Manawyrm/ISA8019/PCB/gerbers/RevA/ISA8019.pdf

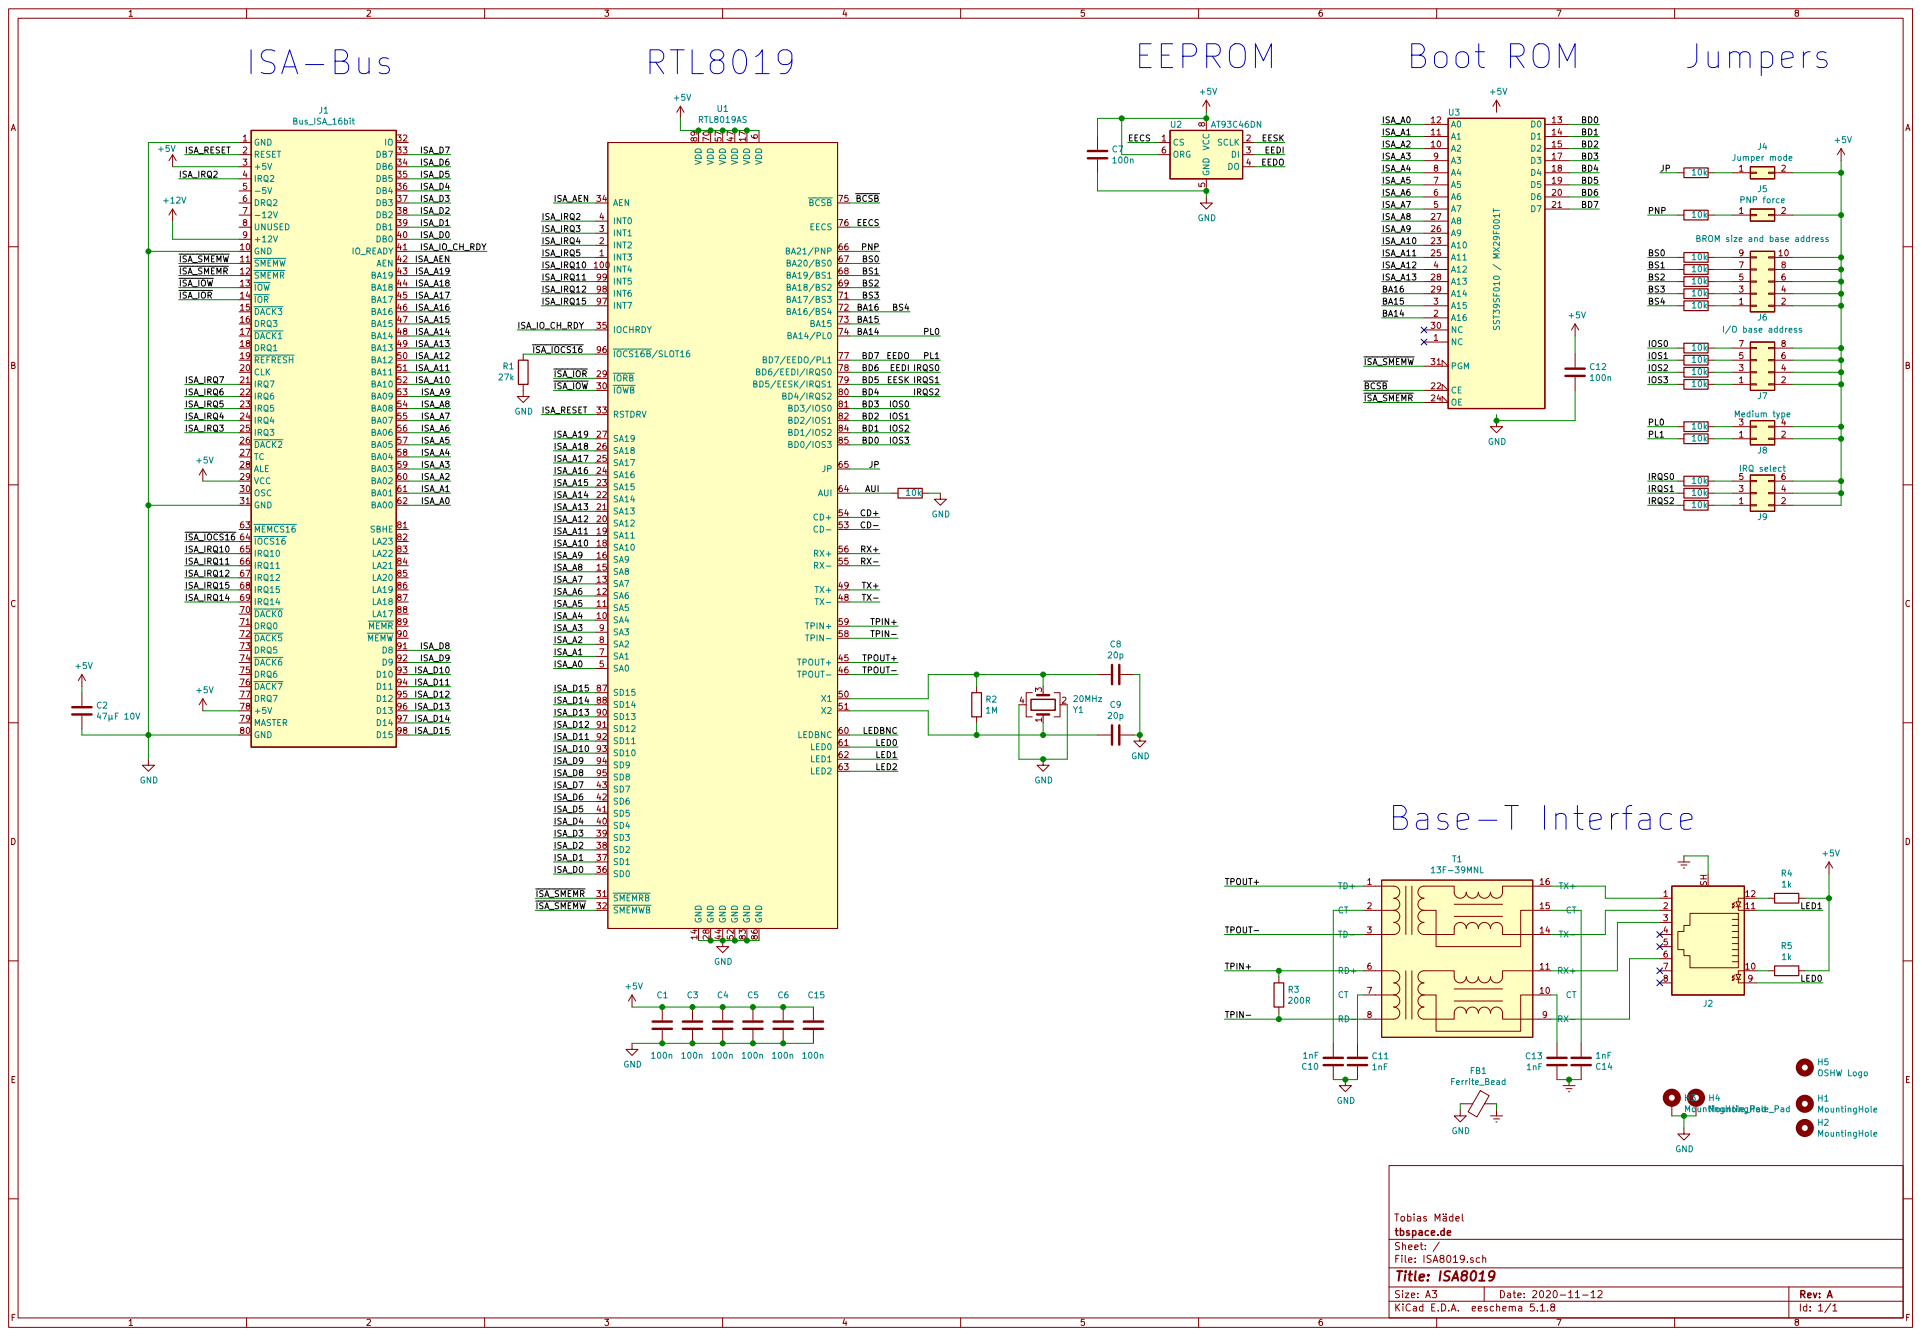
[picture p1: page 1]

J6 BROM size and base address C9

File: ISA8019.sch Sheet: / tbspace.de Tobias Mädel
