Manawyrm/ISA8019/PCB/ISA8019.kicad_pcb

## KiCad design PCB/ISA8019.kicad_pcb (2020-11-15)

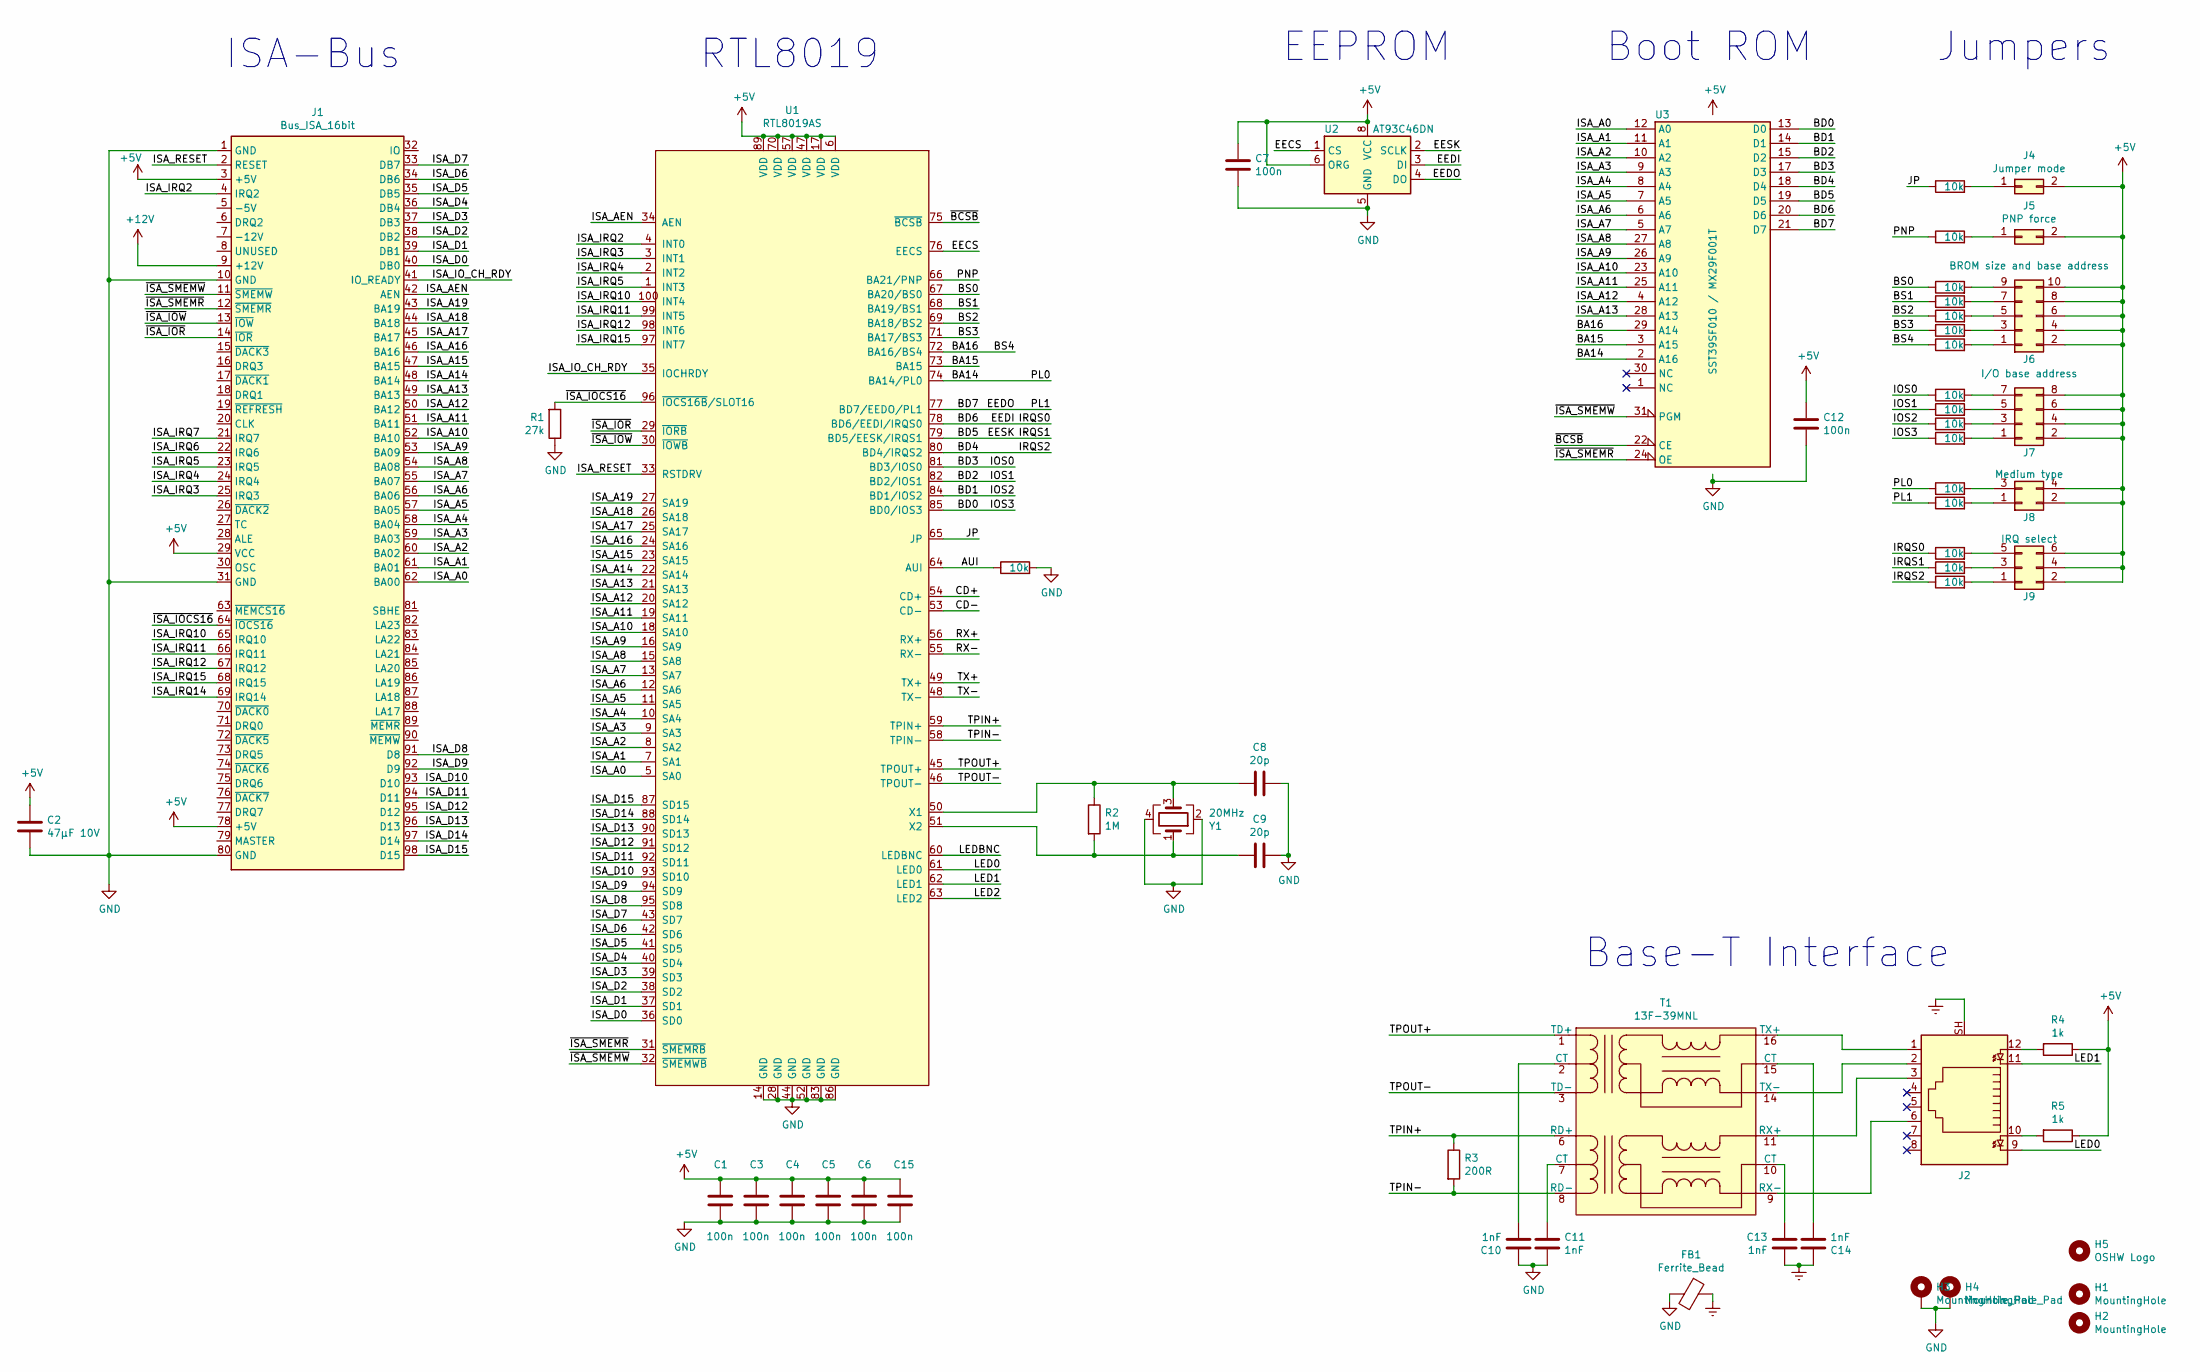
[picture p2: schematic ISA8019.sch]

Parts:
C1, C3, C4, C5, C6, C7, C12, C15: 100n; C_0402_1005Metric; LCSC C1525
C2: 47µF 10V; C_1206_3216Metric; LCSC C96123
C8, C9: 20p; C_0402_1005Metric; LCSC C1554
C10, C11, C13, C14: 1nF; C_1206_3216Metric; LCSC C9196
FB1: Ferrite_Bead; L_0805_2012Metric; LCSC C1017
H1, H2: MountingHole; ToolingHole_JLCSMT
H3, H4: MountingHole_Pad; MountingHole_3.2mm_M3_Pad_Via
H5: OSHW Logo; OSHW-Logo_11.4x12mm_Copper
J1: Bus_ISA_16bit; BUS_AT_WO_SILKSCREEN
J2: 8P8C_Shielded; 8P8C_yellow_green_Ckmtw_C133529
J4: Jumper mode; PinHeader_2x01_P2.54mm_Vertical
J5: PNP force; PinHeader_2x01_P2.54mm_Vertical
J6: BROM size and base address; PinHeader_2x05_P2.54mm_Vertical
J7: I/O base address; PinHeader_2x04_P2.54mm_Vertical
J8: Medium type; PinHeader_2x02_P2.54mm_Vertical
J9: IRQ select; PinHeader_2x03_P2.54mm_Vertical
R1: 27k; R_0402_1005Metric; LCSC C25771
R2: 1M; R_0402_1005Metric; LCSC C26083
R3: 200R; R_0402_1005Metric; LCSC C25087
R4, R5: 1k; R_0402_1005Metric; LCSC C11702
R6, R7, R8, R9, R10, R11, R12, R13, R14, R15, R16, R17, R18, R19, R20, R21, R22: 10k; R_0402_1005Metric; LCSC C25744
T1: 13F-39MNL; SOIC-16W-12_7.5x10.3mm_P1.27mm; LCSC C115949
U1: RTL8019AS; LQFP-14x20mm_P0.5mm; LCSC C10016
U2: AT93C46DN; SOIC-8_3.9x4.9mm_P1.27mm; LCSC C6499
U3: SST39SF010 / MX29F001T; DIP-32_W15.24mm_Socket_LongPads
Y1: 20MHz; Crystal_SMD_3225-4Pin_3.2x2.5mm; LCSC C110936

Connections:
+5V: C1.1, C2.1, C3.1, C4.1, C5.1, C6.1, C7.1, C12.1, C15.1, J1.3 (+5V), J1.29 (VCC), J1.78 (+5V), J4.2, J5.2, J6.2, J6.4, J6.6, J6.8, J6.10, J7.2, J7.4, J7.6, J7.8, J8.2, J8.4, J9.2, J9.4, J9.6, R4.1, R5.1, U1.6 (VDD), U1.17 (VDD), U1.47 (VDD), U1.57 (VDD), U1.70 (VDD), U1.89 (VDD), U2.6 (ORG), U2.8 (VCC), U3.32 (VCC)
+12V: J1.9 (+12V)
/AUI: R6.1, U1.64 (AUI)
/BA14: R18.1, U1.74 (BA14/PL0), U3.2 (A16)
/BA15: U1.73 (BA15), U3.3 (A15)
/BA16: R13.1, U1.72 (BA16/BS4), U3.29 (A14)
/BD0: R17.1, U1.85 (BD0/IOS3), U3.13 (D0)
/BD1: R16.1, U1.84 (BD1/IOS2), U3.14 (D1)
/BD2: R15.1, U1.82 (BD2/IOS1), U3.15 (D2)
/BD3: R14.1, U1.81 (BD3/IOS0), U3.17 (D3)
/BD4: R22.1, U1.80 (BD4/IRQS2), U3.18 (D4)
/BD5: R21.1, U1.79 (BD5/EESK/IRQS1), U2.2 (SCLK), U3.19 (D5)
/BD6: R20.1, U1.78 (BD6/EEDI/IRQS0), U2.3 (DI), U3.20 (D6)
/BD7: R19.1, U1.77 (BD7/EEDO/PL1), U2.4 (DO), U3.21 (D7)
/BS0: R9.1, U1.67 (BA20/BS0)
/BS1: R10.1, U1.68 (BA19/BS1)
/BS2: R11.1, U1.69 (BA18/BS2)
/BS3: R12.1, U1.71 (BA17/BS3)
/CD+: U1.54 (CD+)
/CD-: U1.53 (CD-)
/EECS: U1.76 (EECS), U2.1 (CS)
/ISA_A0: J1.62 (BA00), U1.5 (SA0), U3.12 (A0)
/ISA_A1: J1.61 (BA01), U1.7 (SA1), U3.11 (A1)
/ISA_A2: J1.60 (BA02), U1.8 (SA2), U3.10 (A2)
/ISA_A3: J1.59 (BA03), U1.9 (SA3), U3.9 (A3)
/ISA_A4: J1.58 (BA04), U1.10 (SA4), U3.8 (A4)
/ISA_A5: J1.57 (BA05), U1.11 (SA5), U3.7 (A5)
/ISA_A6: J1.56 (BA06), U1.12 (SA6), U3.6 (A6)
/ISA_A7: J1.55 (BA07), U1.13 (SA7), U3.5 (A7)
/ISA_A8: J1.54 (BA08), U1.15 (SA8), U3.27 (A8)
/ISA_A9: J1.53 (BA09), U1.16 (SA9), U3.26 (A9)
/ISA_A10: J1.52 (BA10), U1.18 (SA10), U3.23 (A10)
/ISA_A11: J1.51 (BA11), U1.19 (SA11), U3.25 (A11)
/ISA_A12: J1.50 (BA12), U1.20 (SA12), U3.4 (A12)
/ISA_A13: J1.49 (BA13), U1.21 (SA13), U3.28 (A13)
/ISA_A14: J1.48 (BA14), U1.22 (SA14)
/ISA_A15: J1.47 (BA15), U1.23 (SA15)
/ISA_A16: J1.46 (BA16), U1.24 (SA16)
/ISA_A17: J1.45 (BA17), U1.25 (SA17)
/ISA_A18: J1.44 (BA18), U1.26 (SA18)
/ISA_A19: J1.43 (BA19), U1.27 (SA19)
/ISA_AEN: J1.42 (AEN), U1.34 (AEN)
/ISA_D0: J1.40 (DB0), U1.36 (SD0)
/ISA_D1: J1.39 (DB1), U1.37 (SD1)
/ISA_D2: J1.38 (DB2), U1.38 (SD2)
/ISA_D3: J1.37 (DB3), U1.39 (SD3)
/ISA_D4: J1.36 (DB4), U1.40 (SD4)
/ISA_D5: J1.35 (DB5), U1.41 (SD5)
/ISA_D6: J1.34 (DB6), U1.42 (SD6)
/ISA_D7: J1.33 (DB7), U1.43 (SD7)
/ISA_D8: J1.91 (D8), U1.95 (SD8)
/ISA_D9: J1.92 (D9), U1.94 (SD9)
/ISA_D10: J1.93 (D10), U1.93 (SD10)
/ISA_D11: J1.94 (D11), U1.92 (SD11)
/ISA_D12: J1.95 (D12), U1.91 (SD12)
/ISA_D13: J1.96 (D13), U1.90 (SD13)
/ISA_D14: J1.97 (D14), U1.88 (SD14)
/ISA_D15: J1.98 (D15), U1.87 (SD15)
/ISA_IO_CH_RDY: J1.41 (IO_READY), U1.35 (IOCHRDY)
/ISA_IRQ2: J1.4 (IRQ2), U1.4 (INT0)
/ISA_IRQ3: J1.25 (IRQ3), U1.3 (INT1)
/ISA_IRQ4: J1.24 (IRQ4), U1.2 (INT2)
/ISA_IRQ5: J1.23 (IRQ5), U1.1 (INT3)
/ISA_IRQ6: J1.22 (IRQ6)
/ISA_IRQ7: J1.21 (IRQ7)
/ISA_IRQ10: J1.65 (IRQ10), U1.100 (INT4)
/ISA_IRQ11: J1.66 (IRQ11), U1.99 (INT5)
/ISA_IRQ12: J1.67 (IRQ12), U1.98 (INT6)
/ISA_IRQ14: J1.69 (IRQ14)
/ISA_IRQ15: J1.68 (IRQ15), U1.97 (INT7)
/ISA_RESET: J1.2 (RESET), U1.33 (RSTDRV)
/JP: R7.1, U1.65 (JP)
/LED0: J2.9, U1.61 (LED0)
/LED1: J2.11, U1.62 (LED1)
/LED2: U1.63 (LED2)
/LEDBNC: U1.60 (LEDBNC)
/PNP: R8.1, U1.66 (BA21/PNP)
/RX+: U1.56 (RX+)
/RX-: U1.55 (RX-)
/TPIN+: R3.1, T1.6 (RD+), U1.59 (TPIN+)
/TPIN-: R3.2, T1.8 (RD-), U1.58 (TPIN-)
/TPOUT+: T1.1 (TD+), U1.45 (TPOUT+)
/TPOUT-: T1.3 (TD-), U1.46 (TPOUT-)
/TX+: U1.49 (TX+)
/TX-: U1.48 (TX-)
/~BCSB: U1.75 (~BCSB), U3.22 (CE)
/~ISA_IOCS16: J1.64 (~IOCS16), R1.2, U1.96 (~IOCS16B~/SLOT16)
/~ISA_IOR: J1.14 (~IOR), U1.29 (~IORB)
/~ISA_IOW: J1.13 (~IOW), U1.30 (~IOWB)
/~ISA_SMEMR: J1.12 (~SMEMR), U1.31 (~SMEMRB), U3.24 (OE)
/~ISA_SMEMW: J1.11 (~SMEMW), U1.32 (~SMEMWB), U3.31 (PGM)
Earth: C13.2, C14.1, FB1.1, J2.SH
GND: C1.2, C2.2, C3.2, C4.2, C5.2, C6.2, C7.2, C8.1, C9.1, C10.1, C11.2, C12.2, C15.2, FB1.2, H3.1, H4.1, J1.1 (GND), J1.10 (GND), J1.31 (GND), J1.80 (GND), R1.1, R6.2, U1.14 (GND), U1.28 (GND), U1.44 (GND), U1.52 (GND), U1.83 (GND), U1.86 (GND), U2.5 (GND), U3.16 (GND), Y1.2, Y1.4
unnamed: C8.2, R2.1, U1.50 (X1), Y1.3
unnamed: C9.2, R2.2, U1.51 (X2), Y1.1
unnamed: C10.2, T1.2 (CT)
unnamed: C11.1, T1.7 (CT)
unnamed: C13.1, T1.10 (CT)
unnamed: C14.2, T1.15 (CT)
unnamed: J2.1, T1.16 (TX+)
unnamed: J2.2, T1.14 (TX-)
unnamed: J2.3, T1.11 (RX+)
unnamed: J2.6, T1.9 (RX-)
unnamed: J2.10, R5.2
unnamed: J2.12, R4.2
unnamed: J4.1, R7.2
unnamed: J5.1, R8.2
unnamed: J6.1, R13.2
unnamed: J6.3, R12.2
unnamed: J6.5, R11.2
unnamed: J6.7, R10.2
unnamed: J6.9, R9.2
unnamed: J7.1, R17.2
unnamed: J7.3, R16.2
unnamed: J7.5, R15.2
unnamed: J7.7, R14.2
unnamed: J8.1, R19.2
unnamed: J8.3, R18.2
unnamed: J9.1, R22.2
unnamed: J9.3, R21.2
unnamed: J9.5, R20.2

Notes on the sheet:
Base-T Interface
ISA-Bus
RTL8019
Boot ROM
Jumpers
EEPROM

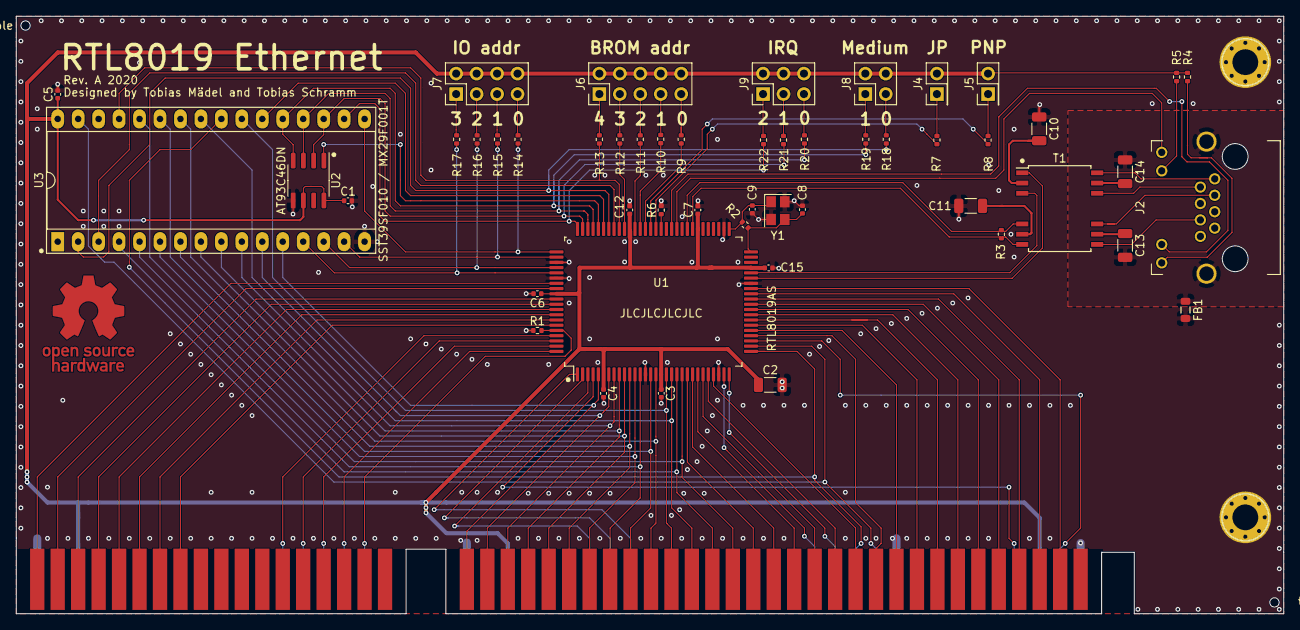
[picture p3: board ISA8019.kicad_pcb from above]

Board: 2 copper layers, 157.4 x 74.2 mm, 56 parts (0 on the bottom side), 109 nets.
