Manawyrm/ISA8019/Drivers/Crynwr packet driver - modified for 8bit operation/README.md

This driver was modified to work with 8bit ISA computers by profdc9.   
  
Source:  
http://www.vcfed.org/forum/showthread.php?41081-NE2000-Packet-drivers-for-8-bit-slots
