Manawyrm/ISA8019/(threads)

Thread 1 (2021-03-31):

Additional hardware

chregu82, 2021-03-31:
Hello
Could you please provide information about the RJ45 connector you used in your design?
Is there any suitable ISA bracket on the market?
Regards
Christian

Manawyrm, 2021-03-31:
Hello Christian,

The RJ45 connector is [Shenzhen Cankemeng C133529](https://lcsc.com/product-detail/Ethernet-Connectors-Modular-Connectors-RJ45-RJ11_Shenzhen-Cankemeng-56-LED_C133529.html)

Just recently, the part also started being [available at JLC for automated assembly](https://jlcpcb.com/parts/componentSearch?searchTxt=C133529).
This feature is brand-new, so I haven't tested it yet.
Every part has a "LCSC" property in KiCad, which contains a LCSC.com part number.
If you add that property with "C133529", automated assembly probably just works fine.

The optional header connectors for the jumpers can also be assembled now, if you add the LCSC part numbers. (again, untested).

The bracket is designed for a [Keystone Electronics 9202](https://www.mouser.de/ProductDetail/534-9202?R=9202virtualkey53400000virtualkey534-9202).

If you get your own boards made, I'd be happy to receive a photo :smiley:

Best regards
Tobias

chregu82, 2021-04-01:
Hello Tobias

Ok I tried adding every needed part for automated assembly at JLCPCB. It was a quite frustrating experience.
- They don't have the DIP socket
- The quarz is out of stock
- They don't have all needed pin headers available
So I would probably have to order the PCB with what they have and do the rest by myself. However it's also quite expensive to let them do the assembly. The RTL8019 alone costs about 8 times as much as if I would order it from Aliexpress.

Because of all that, I then had the idea, why not just order the PCB from JLCPCB and order the parts from Mouser / Aliexpress and do it all by myself. Then I realised that there are 0402 parts, which are really really small for hand soldering and also the quarz would be difficult.

With all this in mind I am now at a point where I think about redesigning what you did and changing it to THT parts where possible. This would probably be a better solution for the experienced hobbyist. Parts could be ordered at Aliexpress / Mouser, maybe even with several options for a specific part or different suppliers.

I'd really like to hear your opinion. The idea of building a NE2000 compatible card for old PCs is really great.

Best regards
Christian

Manawyrm, 2021-04-01:
Hi Christian,

there is a fork of this project where all the small resistors (optimized for JLC) were replaced with 0805 components which are easily handsolderable. (even easier then THT, imho!)

It was discussed in this thread:
https://dosreloaded.de/forum/index.php?thread/3877-neue-isa8019-netzwerkkarte-von-manawyrm/

The only special part is the RTL8019. You can buy everything else directly at LCSC, reichelt, etc.
No real need for mouser (except for the slot covers).

Best regards,
Tobias

Manawyrm, 2021-04-01:
PS: I just looked and saw the price for the RTL8019 at JLC. Oops! That‘s a new development, these things used to cost 0.93$ a couple of month ago!

aperezbios, 2021-11-10:
@Manawyrm FYI, the RJ45 connector part shows as discontinued on LCSC.com as of today: https://lcsc.com/product-detail/Ethernet-Connectors-Modular-Connectors-RJ45-RJ11_Shenzhen-Cankemeng-56-LED_C133529.html

[Further complicating things, LCSC appears to have re-assigned the C133529 part number to a new, completely different connector, made by the same company: ](https://lcsc.com/search?q=C133529)

So, the question then becomes...is there any other, currently-manufactured/available (possibly NOS) connector with a near-identical footprint? I have

aperezbios, 2021-11-10:
It appears this part may be identical, or at least have an identical footprint: https://lcsc.com/product-detail/Ethernet-Connectors-Modular-Connectors-span-style-background-color-ff0-RJ45-span-RJ11_BOOMELE-Boom-Precision-Elec-RJ45-B-1-1_C138392.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

aperezbios, 2021-11-10:
Digging in to this a bit more, it looks like the above Chinese-manufactured part is likely to be a clone/knock-off of the Wurth Elektronik 615008137421. The specification sheet for this part, which includes the mechanical dimensions, can be viewed at https://www.mouser.com/datasheet/2/445/615008137421-1718325.pdf

aperezbios, 2021-11-13:
I can confirm that the Wurth Elektronik 615008137421 part is a perfect match. The Chinese part is likely a clone of it. It mates perfectly in the PCB.
