Manawyrm/ISA8019/(commit log)

2020-11-10 Map pins, add pin type, symbol done
2020-11-12 Add schematic, copy parts of RC2014-Ethernet
2020-11-12 Add EEPROM and boot flash
    [ISA8019.sch]
2020-11-12 Add jumpers, AUI interface
    [ISA8019.kicad_pcb, ISA8019.sch]
2020-11-13 Add mechanicals
    [ISA8019.kicad_pcb, ISA8019.sch]
2020-11-14 Some routing
    [ISA8019-B_Cu.gbl, ISA8019-B_Mask.gbs, ISA8019-B_Paste.gbp, ISA8019-B_SilkS.gbo, ISA8019-Edge_Cuts.gm1, ISA8019-F_Cu.gtl, ISA8019-F_Mask.gts, ISA8019-F_Paste.gtp]
2020-11-14 some routing later
    [ISA8019.kicad_pcb]
2020-11-14 Redo most of the bus layout
    [ISA8019.kicad_pcb]
2020-11-14 Fix BA14/BA15 spacing below ROM
    [ISA8019.kicad_pcb]
2020-11-14 Route all nets
    [ISA8019.kicad_pcb]
2020-11-15 Add silkscreen and jumper settings
    [ISA8019.kicad_pcb, ISA8019.sch]
2020-11-15 Add JLC markings, manufacturing details and new gerbers
    [ISA8019-B_Cu.gbl, ISA8019-B_Mask.gbs, ISA8019-B_Paste.gbp, ISA8019-B_SilkS.gbo, ISA8019-Edge_Cuts.gm1, ISA8019-F_Cu.gtl, ISA8019-F_Mask.gts, ISA8019-F_Paste.gtp]
2020-11-15 More GND via stitching and minor aesthetic fixes
    [ISA8019.kicad_pcb]
2020-11-15 Small trace cleanup and new gerbers
    [ISA8019-B_Cu.gbl, ISA8019-B_Mask.gbs, ISA8019-B_Paste.gbp, ISA8019-B_SilkS.gbo, ISA8019-Edge_Cuts.gm1, ISA8019-F_Cu.gtl, ISA8019-F_Mask.gts, ISA8019-F_Paste.gtp]
2020-12-03 Add schematic .pdf, drivers, programming utilities
    [8019.cfg, 8019as.cfg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]
